dev-gabin/Retrace-Project/jetson_nano/client/wifi/README.md

# Wi-Fi client

Reserved for the future Wi-Fi relay client. The protocol and implementation
are intentionally not defined yet.
