dev-gabin/Retrace-Project/docs/pinmap.md

# Retrace 핀맵

> Retrace 프로젝트의 MCU 보드 3개(STM32 ×2, ESP32 ×1) 핀 배정과 설정 정리.
> 메시지 형식은 [protocol.md](protocol.md)를 참고합니다. Jetson Nano는 USB 장치만 연결하므로 핀맵 대상이 아닙니다.

| 보드 | 역할 | 프로젝트 폴더 | Jetson 연결 | 상태 |
|---|---|---|---|---|
| **STM32 #1** (NUCLEO-F411RE) | 메인 유닛 (Pan/Tilt 서보, 레이저, PIR) | `stm32/main_unit` | USB Serial (VCP) | 펌웨어·빌드 완료 / 실물 확인 전 |
| **STM32 #2** (NUCLEO-F411RE) | 서랍 노드 (서보 ×6, LED ×6, 비상 버튼) | `stm32/drawer` | Bluetooth (HC-06) | 펌웨어·빌드 완료 / 실물 확인 전 |
| **ESP32 #1** (LOLIN D32) | 현관등 (PIR, LED) | `esp32/entrance_node` | Wi-Fi · TCP | GPIO34/25 구현·빌드 완료 / 실물 확인 전 |

---

## 1. STM32 공통

두 STM32 보드 모두 같은 보드·같은 설정 기준을 사용합니다.

### 1-1. 보드 기본 설정 (두 보드 모두 유지)

> 표의 **헤더 핀**(D0~D15, A0~A5)은 NUCLEO 보드에 인쇄된 핀 이름입니다. 배선할 때 보드에서 바로 찾을 수 있습니다.  
> `CN7`, `CN10`은 보드 양옆의 긴 핀 줄입니다.

| 핀 | 용도 | 비고 |
|---|---|---|
| PA2, PA3 | USART2 → ST-LINK VCP | #1은 Jetson 통신, #2는 PC 명령·응답 테스트용. 헤더 D0/D1에는 기본적으로 연결되지 않음 |
| PA13, PA14, PB3 | SWD (TMS, TCK, SWO) | 업로드·디버깅용 |
| PA5 (D13) | LD2 녹색 LED | 디버깅용으로 사용 가능 |
| PC13 | B1 파란 버튼 (EXTI13) | 보드 기본 설정 유지 |
| PC14, PC15 / PH0, PH1 | 외부 크리스털 (LSE / HSE) | |

### 1-2. 클럭

| 항목 | 값 |
|---|---|
| 클럭 소스 | HSI 16MHz → PLL |
| SYSCLK / HCLK | 84 MHz |
| APB1 peripheral clock | 42 MHz |
| **APB1 timer clock** | **84 MHz** (메인 유닛 TIM3 기준 클럭) |

### 1-3. STM32 직접 구동 서보 PWM 계산

> 이 설정은 메인 유닛의 Pan/Tilt 서보에 적용합니다. 서랍 노드는 STM32 타이머 대신 I2C2로 연결한 PCA9685를 사용합니다.

| 항목 | 값 |
|---|---|
| Prescaler (PSC) | **83** |
| Counter Period (ARR) | **19999** |
| auto-reload preload | Enable |
| PWM Mode | PWM mode 1 |
| Output compare preload | Enable |
| CH Polarity | High |

```text
PWM 주파수 = 타이머 클럭 / ((PSC + 1) × (ARR + 1))

84 MHz ÷ (83 + 1) = 1 MHz    → 카운터 1 증가 = 1µs
1µs × (19999 + 1) = 20 ms    → 50Hz (서보 주기)
```

**Pulse 값 의미** (1 = 1µs)

| Pulse | 펄스 폭 | 서보 위치 (일반적) |
|---|---|---|
| 0 | PWM HIGH 신호 없음 | 위치 유지·움직임은 서보 실물에서 확인 |
| 1000 | 1.0 ms | 한쪽 끝 |
| 1500 | 1.5 ms | 중앙 |
| 2000 | 2.0 ms | 반대쪽 끝 |

- SG90은 제품마다 실제 동작 범위가 다를 수 있음 → 보드 테스트로 최소/최대값 확인 필요.

### 1-4. Project Manager

| 항목 | 값 |
|---|---|
| Toolchain / IDE | CMake |
| Firmware Package | STM32Cube FW_F4 **V1.28.3** (두 보드 동일, 최신 버전으로 마이그레이션하지 않음) |
| 주변장치 초기화 코드 위치 | `main.c` 안에 생성 (별도 `tim.c`, `usart.c` 파일 생성 안 함) |

> CubeMX에서 `.ioc`를 열 때 버전 마이그레이션 창이 뜨면 **Continue** 선택.  
> `Migrate to the latest supported Firmware version` 버튼은 누르지 않음 (팀원·강의실 환경 호환 유지).

### 1-5. 빌드 환경

| 항목 | 내용 |
|---|---|
| 에디터 | VS Code + **STM32CubeIDE for Visual Studio Code** 확장 팩 |
| 도구(번들) | 각 프로젝트 `.settings/bundles-lock.store.json`에 고정된 버전 사용 (CMake 4.3.1, Ninja 1.13.2, gnu-tools-for-stm32 14.3.1 — 두 프로젝트 동일) |
| 열 폴더 | `stm32/main_unit` 또는 `stm32/drawer` (각각 따로 열기) |
| 빌드 | `F7` (CMake: Build), 프리셋 `Debug` |
| 성공 기준 | 출력 탭 `CMake/빌드` → `빌드가 완료됨(종료 코드: 0)` |

- 빌드 결과물 `build/`는 각 프로젝트의 `.gitignore`로 제외됨.
- 줄바꿈 규칙은 최상위 `.gitattributes`(`* text=auto`)로 고정.

> **새 PC에서 빌드가 안 될 때** (`arm-none-eabi-gcc ... was not found in the PATH`)
> 1. 확장 **팩**(STM32CubeIDE for Visual Studio Code)이 설치됐는지 확인 — 일부 확장만 있으면 CMake가 컴파일러 위치를 모름
> 2. 프로젝트 폴더에서 VS Code 터미널로 `cube bundle install --project` (잠금 파일 기준으로 도구 설치)
> 3. `build/` 폴더 삭제 → `Developer: Reload Window` → STM32Cube 프로젝트 구성 **예** → `F7`

### 1-6. 공통 배선

| 항목 | 내용 |
|---|---|
| 서보 전원 | **외부 5V** 사용 (보드 5V에서 직접 X) |
| GND | 외부 5V 전원 GND와 NUCLEO GND **공통 연결** (필수) |

---

## 2. STM32 #1 메인 유닛 (레이저·Pan/Tilt·PIR)

### 2-1. 담당 기능

| 기능 | 설명 |
|---|---|
| Jetson 통신 | ST-LINK USB Serial(VCP), 명령 수신 / 이벤트 송신 (`protocol.md` 2장) |
| Pan/Tilt 서보 | SG90 ×2, 레이저 조준 |
| 레이저 | KY-008, ON/OFF |
| PIR | 공간 내 움직임 감지 → Jetson에 이벤트 전달 |

### 2-2. 핀 배정 (확정)

| 기능 | MCU 핀 | 헤더 핀 | 주변장치 | User Label |
|---|---|---|---|---|
| Jetson 통신 TX | PA2 | (D1, 기본 미연결) | USART2_TX | - |
| Jetson 통신 RX | PA3 | (D0, 기본 미연결) | USART2_RX | - |
| Pan 서보 | PA6 | D12 | TIM3_CH1 (PWM) | `SERVO_PAN` |
| Tilt 서보 | PA7 | D11 | TIM3_CH2 (PWM) | `SERVO_TILT` |
| 레이저 | PA8 | D7 | GPIO_Output | `LASER_EN` |
| PIR | PA10 | D2 | GPIO_EXTI10 | `PIR_IN` |

### 2-3. CubeMX 설정

**USART2 (Jetson 통신)**

| 항목 | 값 |
|---|---|
| Mode | Asynchronous |
| Baud Rate | **115200** |
| Word Length / Parity / Stop Bits | 8 / None / 1 |
| Data Direction | Receive and Transmit |
| NVIC | USART2 global interrupt **Enable** |

**TIM3 (Pan/Tilt)** — 1-3 공통 설정 + 아래

| 항목 | 값 |
|---|---|
| Channel1 / Channel2 | PWM Generation CH1 (PA6) / CH2 (PA7) |
| Pulse (CH1, CH2) | **1500** (중앙에서 시작) |

**PA8 (레이저)**

| 항목 | 값 |
|---|---|
| Mode | GPIO_Output |
| Output level | Low (부팅 시 레이저 OFF) |
| GPIO mode | Output Push Pull |
| Pull-up/Pull-down | No pull |
| Speed | Low |

**PA10 (PIR)**

| 항목 | 값 |
|---|---|
| Mode | GPIO_EXTI10 |
| GPIO mode | External Interrupt, Rising/Falling edge |
| Pull-up/Pull-down | Pull-down |
| NVIC | EXTI line[15:10] interrupts **Enable** |

- Rising = 움직임 감지 시작, Falling = 감지 종료 → 둘 다 받아서 활동 상태 판단에 사용.
- Pull-down: 센서가 빠졌을 때 입력이 떠서 오작동하는 것 방지.

> **주의: PA10(PIR)과 PC13(B1 버튼)은 같은 인터럽트(`EXTI15_10_IRQn`)를 공유함.**  
> 콜백(`HAL_GPIO_EXTI_Callback`)에서 `GPIO_Pin` 값으로 `PIR_IN_Pin`인지 `B1_Pin`인지 구분해서 처리해야 함.

### 2-4. 생성 코드에서 사용하는 이름

`Core/Inc/main.h`에 자동 생성됨.

| 매크로 | 값 |
|---|---|
| `SERVO_PAN_Pin` / `SERVO_PAN_GPIO_Port` | `GPIO_PIN_6` / `GPIOA` |
| `SERVO_TILT_Pin` / `SERVO_TILT_GPIO_Port` | `GPIO_PIN_7` / `GPIOA` |
| `LASER_EN_Pin` / `LASER_EN_GPIO_Port` | `GPIO_PIN_8` / `GPIOA` |
| `PIR_IN_Pin` / `PIR_IN_GPIO_Port` | `GPIO_PIN_10` / `GPIOA` |
| `PIR_IN_EXTI_IRQn` | `EXTI15_10_IRQn` |

### 2-5. 배선 메모

| 항목 | 내용 | 상태 |
|---|---|---|
| 레이저 | GPIO 직결 대신 트랜지스터 스위칭 검토 | 확인 필요 (모듈 전류) |
| PIR | 전원 5V, 출력 3.3V면 PA10 직결 가능 | 확인 필요 (모델) |

### 2-6. 진행 상황

- [x] CubeMX 핀 배정 (충돌 없음)
- [x] Clock 확인 → APB1 timer clock 84MHz, PSC 83 확정
- [x] 코드 생성 및 라벨·타이머 값 반영 확인
- [x] 명령 수신·AIM·LASER·HOME·PIR 이벤트 구현
- [x] 빌드 성공·경고 0개
- [ ] 레이저 모듈 모델 및 전류 확인
- [ ] PIR 센서 모델 및 출력 전압 확인
- [ ] 보드 업로드 및 동작 확인
- [ ] SG90 실제 동작 범위(Pulse 최소/최대) 측정

---

## 3. STM32 #2 서랍 노드

> 현재 핀 배정은 `drawer.ioc`와 아래 표를 기준으로 합니다. 통신 메시지는 `protocol.md` 기준입니다.

### 3-1. 담당 기능

| 기능 | 설명 |
|---|---|
| 서랍 팝업 서보 | SG90 ×6, PCA9685의 CH0~CH5로 제어 |
| 서랍 LED | LED ×6, 열린 서랍 표시 (타이머 자동 소등) |
| 비상 버튼 | Jetson 서버 로그 이벤트 (`EVT@clientID:SOS`); 폰 사이렌은 후속 구현 |
| Jetson 통신 | HC-06 Bluetooth (USART1) (`protocol.md` 3장) |
| PC 테스트 | ST-LINK VCP (USART2) — 명령 수신 · 응답 및 SOS 이벤트 |

### 3-2. 서랍 번호

`protocol.md`의 `clientID:OPEN:n`, `LED:n:ON`의 **n은 아래 번호**를 따릅니다. 서보·LED 번호도 같습니다.

```text
┌─────────┬─────────┐
│    1    │    2    │   Top
├─────────┼─────────┤
│    3    │    4    │   Middle
├─────────┼─────────┤
│    5    │    6    │   Bottom
└─────────┴─────────┘
   Left      Right
```

### 3-3. 핀 배정

**PCA9685 I2C 연결**

| PCA9685 핀 | STM32 핀 | 헤더 핀 | 설정 |
|---|---|---|---|
| SCL | PB10 | D6 | I2C2_SCL |
| SDA | PB9 | D14 | I2C2_SDA |
| VCC | 3.3V | | 로직 전원 |
| GND | GND | | 공통 접지 |

서보는 **1~6번 각 서랍 뒤에 1개씩** 설치하고, PCA9685 채널도 같은 번호 순서로 사용합니다.

| 서랍 | 위치 | PCA9685 채널 |
|---|---|---|
| 1 | 상단 왼쪽 | CH0 |
| 2 | 상단 오른쪽 | CH1 |
| 3 | 중단 왼쪽 | CH2 |
| 4 | 중단 오른쪽 | CH3 |
| 5 | 하단 왼쪽 | CH4 |
| 6 | 하단 오른쪽 | CH5 |

**서랍 LED**

| 서랍 | 핀 | 헤더 핀 | 설정 | User Label |
|---|---|---|---|---|
| 1 | PA0 | A0 | GPIO_Output | `LED_1` |
| 2 | PA1 | A1 | GPIO_Output | `LED_2` |
| 3 | PA4 | A2 | GPIO_Output | `LED_3` |
| 4 | PB0 | A3 | GPIO_Output | `LED_4` |
| 5 | PC1 | A4 | GPIO_Output | `LED_5` |
| 6 | PC0 | A5 | GPIO_Output | `LED_6` |

**HC-06 Bluetooth**

| HC-06 핀 | STM32 핀 | 헤더 핀 | 설정 |
|---|---|---|---|
| RXD | PA9 | D8 | USART1_TX (`HC06_TX`) |
| TXD | PA10 | D2 | USART1_RX (`HC06_RX`) |
| VCC | 5V | | 전원 |
| GND | GND | | 공통 접지 |

- TX ↔ RX **교차 연결** (STM32 TX → HC-06 RXD)
- STM32는 3.3V 로직이라 **전압 분배 저항 없이** 연결
- 서랍 보드엔 PIR이 없어서 PA10을 USART1_RX로 사용 (메인 유닛 STM32 #1과 다름)

**비상 버튼**

| 부품 핀 | STM32 핀 | 헤더 핀 | 설정 | User Label |
|---|---|---|---|---|
| 버튼 신호 | PB5 | D4 | GPIO_Input, Pull-up | `SOS_BTN` |
| 버튼 반대쪽 | GND | | 공통 접지 | |

- 평소 Pull-up으로 HIGH → 누르면 GND와 연결되어 LOW
- 인터럽트 없이 메인 루프에서 폴링하며 코드에서 50ms 디바운싱

**미사용 핀**

| 핀 | 상태 |
|---|---|
| PB1 | 사용 안 함 |

### 3-4. CubeMX 설정

**I2C2 (PCA9685)**

| 항목 | 값 |
|---|---|
| Mode | I2C |
| Clock Speed | **100000 Hz** (Standard Mode) |
| Addressing Mode | 7-bit |
| SCL / SDA | PB10 / PB9 |
| GPIO | Alternate Function Open Drain, No pull, Very High speed |
| DMA / NVIC | 사용 안 함 (폴링 방식) |
| PCA9685 주소 | 7-bit `0x40` (HAL 전달값 `0x40 << 1`) |
| PCA9685 PWM | **50Hz**, CH0~CH5 사용 |

> TIM3/TIM4는 사용하지 않습니다. 부팅 시 PCA9685 CH0~CH5를 Full OFF로 두고, 복귀·밀어내기 펄스 값은 실물 테스트에서 맞춥니다.

**USART1 (HC-06)**

| 항목 | 값 |
|---|---|
| Mode | Asynchronous |
| Baud Rate | **9600** (HC-06 기본값, 모듈 확인 필요) |
| Word Length / Parity / Stop Bits | 8 / None / 1 |
| NVIC | USART1 global interrupt **Enable** |

**USART2 (디버그)** — 보드 기본값 유지 (115200, VCP)

- USB 명령 테스트를 위해 USART2 NVIC는 `stm32f4xx_hal_msp.c`의 `USER CODE`에서 활성화하고, `stm32f4xx_it.c`의 `USER CODE`에 IRQ 핸들러를 정의합니다. `.ioc`는 변경하지 않았습니다.
- 나중에 CubeMX에서 USART2 global interrupt를 켜면 자동 생성 핸들러와 수동 핸들러가 중복되지 않도록 정리해야 합니다.

**GPIO**

| 핀 | 설정 |
|---|---|
| PA0, PA1, PA4, PB0, PC1, PC0 | GPIO_Output, Output level **Low**(부팅 시 꺼짐), Push Pull, No pull, Speed Low |
| PB5 | GPIO_Input, **Pull-up** (`SOS_BTN`) |
| NVIC | SOS 버튼 및 I2C2 인터럽트 사용 안 함 |

**Project Manager** — 1-4 공통 + Project Name `drawer`, Location `Retrace-Project/stm32/`

### 3-5. 배선 메모

| 항목 | 내용 |
|---|---|
| PCA9685 로직 전원 | VCC는 STM32 **3.3V**에 연결 |
| 서보 전원 | PCA9685 V+에 외부 **5~6V, 2A 이상** 권장 (서보 6개) |
| I2C | PB10(D6) → SCL, PB9(D14) → SDA; 모듈의 풀업 저항 사용 |
| GND | 외부 서보 전원 GND · PCA9685 GND · STM32 GND · HC-06 GND **공통 연결** |
| 서보 동작 | 코드에서 **한 번에 하나씩만** 움직이게 해서 전류 몰림 방지 |
| LED | 핀마다 **전류 제한 저항**(220~330Ω) 직렬 연결 |
| 비상 버튼 | 내부 Pull-up 사용 → 외부 저항 불필요, 채터링은 코드에서 처리 |

### 3-6. 진행 상황

- [x] 프로젝트 생성 (`drawer.ioc`, NUCLEO-F411RE, 보드 기본 설정)
- [x] TIM3/TIM4 비활성화
- [x] I2C2: PB10/PB9 = SCL/SDA, Standard Mode 100kHz
- [x] PCA9685: CH0~CH5 = 서랍 1~6, 50Hz 제어 코드 구현
- [x] USART1: PA9/PA10 = `HC06_TX`/`HC06_RX`, 9600, NVIC
- [x] GPIO: PA0/PA1/PA4/PB0/PC1/PC0 = `LED_1~6`
- [x] PB5 = `SOS_BTN` (GPIO Input, Pull-up, 폴링)
- [x] Project Manager → 코드 생성
- [x] UART 명령 · LED · 서보 순차 밀기·복귀 · 10초 소등 · SOS 이벤트 구현
- [x] PCA9685 전환 후 Debug 빌드 성공·경고 0개
- [ ] I2C 연결 · PCA9685 주소 · 서보 펄스 보정 · 보드 업로드 및 실물 동작 확인

### 3-7. 확인 필요 항목

- [ ] 서랍 실제 배치 (2열× 3행 맞는지, LED 연결이 위 번호 그림과 일치하는지)
- [ ] HC-06 통신 속도 (9600 기본값인지)
- [ ] PCA9685 주소 `0x40` 응답 및 50Hz 출력 확인
- [ ] 서보 복귀 / 밀어내기 Pulse 값 보정 (현재 1000µs / 2000µs)
- [ ] PB1 미사용 이유 기록

---

## 4. ESP32 공통

### 4-1. 개발 방식

| 항목 | 내용 |
|---|---|
| 개발 도구 | VS Code + **PlatformIO** (STM32와 같은 에디터) |
| 프레임워크 | Arduino 프레임워크 (`setup()` / `loop()`) |
| 설정 파일 | 각 프로젝트의 `platformio.ini` (보드 · 라이브러리 버전) |
| 핀 설정 | CubeMX 같은 설정 화면 없음 → **코드에서 직접** (`pinMode()`) |
| 빌드 결과물 | `.pio/` → `.gitignore`로 제외 |

### 4-2. 피해야 할 핀 (확인 필요 — 보드 문서로 최종 확인)

ESP32는 **전원 켤 때 부팅 방식을 정하는 핀(스트래핑 핀)**이 있어서, 여기에 부품을 달면 부팅이 안 될 수 있습니다.

| 보드 | 피할 핀 | 이유 |
|---|---|---|
| LOLIN D32 | GPIO0, 2, 5, 12, 15 | 부팅 모드 결정 (스트래핑) |
| LOLIN D32 | GPIO6~11 | 내부 플래시 메모리 연결 |
| LOLIN D32 | GPIO34~39 | **입력 전용** (출력 불가, 내부 풀업·풀다운 없음) |
| ESP32-C3 | GPIO2, 8, 9 | 부팅 모드 결정 (스트래핑) |
| ESP32-C3 | GPIO18, 19 | USB 연결 (업로드·시리얼) |
| ESP32-C3 | GPIO20, 21 | UART0 (기본 시리얼) |

---

## 5. ESP32 #1 현관등 (LOLIN D32)

### 5-1. 담당 기능

| 기능 | 설명 |
|---|---|
| 외출 감지 | PIR 움직임 → TCP `EVT@ENTRANCE:PIRON` |
| 현관등 | 평소 센서등 점등 / Jetson `ALERT` 명령 시 경고 점등 |
| Jetson 통신 | Wi-Fi · 인증 TCP client (`protocol.md` 4장) |

### 5-2. 코드에 반영한 핀 배정 (실물 검증 전)

| 부품 | 핀 | 설정 | 코드 상수 |
|---|---|---|---|
| PIR 출력 | **GPIO34** | `INPUT` | `PIR_PIN` |
| 현관등 LED | **GPIO25** | `OUTPUT`, 초기 LOW, 한 색 LED | `LIGHT_PIN` |

- **PIR → GPIO34**: 입력 전용 핀이라 센서 입력에 적합. 내부 풀다운이 없으므로 센서가 빠졌을 때 오작동이 걱정되면 **외부 10kΩ 풀다운** 추가
- **현관등 LED**: GPIO25로 제어. 저항 내장 모듈이 아니면 220~330Ω 전류 제한 저항을 직렬 연결.

- PIR 50ms 필터, 움직임 종료 후 7초 점등 유지. `ALERT`는 250ms마다 ON/OFF하며 10초 후 기본 센서등 모드로 복귀.
- Wi-Fi·TCP가 없어도 기본 센서등 동작. 실제 업로드·PIR·LED·네트워크 검증은 강의실에서 진행.

### 5-3. 배선 메모

| 항목 | 내용 | 상태 |
|---|---|---|
| 전원 | USB 5V 어댑터 (시연용) | |
| PIR 전원 | HC-SR501은 5V 필요, 출력은 3.3V라 GPIO 직결 가능 | 확인 필요 (모델) |
| 배터리 | 배터리로만 쓰면 5V가 없을 수 있음 → 3.3V용 PIR(AM312 등) 검토 | 시연은 USB 전원 |

---

### 5-4. 진행 상황

- [x] PIR 센서등·시간 유지·NORMAL/ALERT·Wi-Fi/TCP·재연결 구현
- [x] 기본·네트워크 활성화 빌드 성공·경고 0개
- [ ] 개인 `network_config.h`에 Wi-Fi·Jetson IP 입력 후 실제 보드용 `lolin_d32` 재빌드·업로드
- [ ] PIR·LED 구동, 실제 TCP 로그인·이벤트·연결 유실 검증

---

## 6. 전체 확인 필요 항목

- [ ] STM32 #1: 레이저 모듈 전류, PIR 모델, SG90 동작 범위
- [ ] STM32 #2: PCA9685 I2C 연결·주소, 서랍 실제 배치, HC-06 통신 속도, 서보 밀기·복귀 펄스와 시간 보정, PB1 미사용 이유
- [ ] ESP32 #1: PIR 모델, 한 색 LED 구동 회로·실제 점등, Wi-Fi/TCP 연결

실행 항목과 결과 기록은 [강의실 통합 테스트](classroom_test_checklist.md)에서 관리합니다. 보드 단독 검증 후 feature → develop PR로 기능을 통합하고 Jetson·웹과 전체 연동을 확인합니다.
