dev-gabin/Retrace-Project/docs/protocol.md

# Retrace 통신 프로토콜

> 각 보드가 주고받는 메시지 약속입니다. **보내는 쪽과 받는 쪽 모두 이 문서를 기준으로 구현합니다.**  
> 문서와 다르게 동작하면 **문서와 다른 쪽이 수정**합니다. 변경이 필요하면 문서를 먼저 고치고 서로 공유합니다.
>
> 버전: **v0.8** — 현재 `develop` 구현 기준입니다.
> 보드 핀 배정은 [pinmap.md](pinmap.md), 실행·검증 항목은 [통합 테스트 체크리스트](classroom_test_checklist.md)를 참고합니다.

---

## 0. 전체 연결

| 연결 | 방식 | 보드 쪽 (담당: 본인) | Jetson 쪽 (담당: 짝꿍) |
|---|---|---|---|
| Jetson ↔ STM32 #1 메인 유닛 | USB Serial (VCP) | `stm32/main_unit` | `Stm32Link` |
| Jetson ↔ STM32 #2 서랍 | Bluetooth (HC-06) | `stm32/drawer` | `DrawerLink` |
| Jetson ↔ ESP32 #1 현관등 (LOLIN D32) | Wi-Fi · TCP | `esp32/entrance_node` | 인증 client |
| Jetson → 스마트폰 | ntfy (HTTP) | - | `PhoneNotifier` |
| Web/PWA ↔ Jetson | HTTP | - | `Server` |

> 카메라는 Jetson에 USB로 직접 연결되며(영상 입력), 이 문서의 메시지 대상이 아닙니다.

---

## 1. 시리얼 공통 규칙 (STM32 #1, STM32 #2)

USB Serial과 Bluetooth(HC-06) 모두 **같은 문자 형식**을 씁니다. PC 시리얼 터미널로 직접 입력해서 테스트할 수 있습니다.

| 항목 | 규칙 |
|---|---|
| 문자 | ASCII |
| 대소문자 | **대문자만** 사용. 보내는 쪽·받는 쪽 모두 대문자 기준이며, 소문자가 섞인 명령은 `ERR:UNKNOWN` (테스트할 때도 대문자로 입력) |
| 형식 | 필드는 `:`로 구분, 한 필드 안의 여러 값은 `,`로 구분 (예: `AIM:120,45`, `DRAWER:OPEN:3`, `LED:3:ON`) |
| 줄 끝 | `\n` (LF) 한 개로 메시지 하나 끝 (`\r`은 받는 쪽에서 무시) |
| 공백 | 사용하지 않음 |
| 최대 길이 | 32바이트 (`\n` 포함) |

### 응답 · 이벤트

| 종류 | 형식 | 예 |
|---|---|---|
| 성공 응답 | `OK:명령` | `OK:AIM` |
| 실패 응답 | `ERR:명령:이유` | `ERR:AIM:RANGE` |
| 모르는 명령 | `ERR:UNKNOWN` | |
| 보드가 먼저 보내는 이벤트 | `EVT@종류:값` | `EVT@PIR:1` |

- 명령을 받으면 **반드시 `OK` 또는 `ERR`로 응답**합니다.
- Jetson은 응답을 **1초** 기다리고, 없으면 **1회 재전송**합니다. 그래도 없으면 연결 오류로 처리합니다.
- **이벤트(`EVT:`)는 언제든 올 수 있습니다.** Jetson은 응답을 기다리는 중에도 `EVT:`로 시작하는 줄은 응답이 아니라 **이벤트로 처리**하고, 계속 응답을 기다립니다.

```text
Jetson → AIM:90,90
STM32  → EVT@PIR:1     ← 응답 대기 중 이벤트 도착 → 이벤트로 처리
STM32  → OK:AIM        ← 이게 AIM의 응답
```

### 공통 명령

| 명령 | 응답 | 설명 |
|---|---|---|
| `PING` | `OK@PING` | 연결 확인 |

---

## 2. Jetson ↔ STM32 #1 메인 유닛 (USB Serial)

카메라와 STM32 #1은 **같은 메인 유닛**에 배치하며, STM32 #1과 Jetson은 USB로 연결합니다.

| 항목 | 값 |
|---|---|
| 포트 | ST-LINK VCP (STM32 USART2: PA2/PA3), Jetson에서 `/dev/ttyACM*` |
| 설정 | 115200, 8N1 |

### Jetson → STM32 #1

| 명령 | 응답 | 설명 |
|---|---|---|
| `AIM:pan,tilt` | `OK:AIM` | 서보 각도 이동. 각도는 **0~180 정수(도)** |
| `LASER:ON` | `OK:LASER` | 레이저 켜기 |
| `LASER:OFF` | `OK:LASER` | 레이저 끄기 |
| `HOME` | `OK:HOME` | 서보 중앙(90,90) + 레이저 OFF |

- 범위 밖 각도 → `ERR:AIM:RANGE`
- 카메라 좌표 → 각도 변환(조준 보정)은 **Jetson**에서 하고, STM32는 **받은 각도만** 서보 펄스로 바꿉니다.
- 각도 → 펄스 변환(SG90 최소/최대 펄스)은 STM32가 담당합니다.

### STM32 #1 → Jetson (이벤트)

| 이벤트 | 설명 |
|---|---|
| `EVT@PIR:1` | 움직임 감지 시작 |
| `EVT@PIR:0` | 움직임 감지 종료 |

예시:

```text
Jetson → AIM:120,45
STM32  → OK:AIM
Jetson → LASER:ON
STM32  → OK:LASER
STM32  → EVT@PIR:1
```

---

## 3. Jetson ↔ STM32 #2 서랍 (Bluetooth, HC-06)

| 항목 | 값 |
|---|---|
| 연결 | HC-06 (Bluetooth Classic, SPP) ↔ STM32 USART1 (PA9/PA10), Jetson에서 `/dev/rfcomm*` |
| 설정 | **9600**, 8N1 (HC-06 기본값, 모듈 확인 필요) |
| Jetson 쪽 | USB Bluetooth 동글 (CSR 4.0) |

> STM32 #2의 USART2(VCP, 115200 8N1)는 **PC 단독 테스트용**으로 같은 명령을 받습니다. 응답은 명령을 받은 UART로 보내며, SOS 이벤트는 USART1과 USART2 양쪽으로 보냅니다. Jetson 연결은 USART1(HC-06)을 사용합니다.

**서랍 번호 n** (서보·LED 번호와 동일, `pinmap.md` 3-2)

```text
┌─────────┬─────────┐
│    1    │    2    │   Top
├─────────┼─────────┤
│    3    │    4    │   Middle
├─────────┼─────────┤
│    5    │    6    │   Bottom
└─────────┴─────────┘
   Left      Right
```

### Jetson → STM32 #2

| 명령 | 응답 | 설명 |
|---|---|---|
| `DRAWER:OPEN:n` | `OK:DRAWER` | n번 서랍(1~6) LED ON + 팝업 서보 동작 |
| `LED:n:ON` | `OK:LED` | n번 LED만 켜기 |
| `LED:n:OFF` | `OK:LED` | n번 LED만 끄기 |
| `LED:ALL:OFF` | `OK:LED` | 전체 LED 끄기 |

- 범위 밖 번호 → `ERR:DRAWER:RANGE`, `ERR:LED:RANGE`
- 서보 밀어내기·복귀는 **STM32가 처리**합니다. Jetson은 서랍 번호만 보냅니다. 현재 밀기 2000µs / 복귀 1000µs, 각각 500ms이며 실물 보정 전 임시값입니다. 복귀는 서보 팔 복귀이며 서랍을 자동으로 닫지 않습니다.
- LED 점등 명령 이후 마지막 점등 시각부터 현재 **10초** 뒤 STM32가 자동 소등합니다. 서랍 닫힘 감지는 없습니다. 시간은 강의실에서 조정합니다.
- 새 `DRAWER:OPEN`이 오면 **이전 LED는 즉시 소등**하고 새 서랍만 켭니다.
- 서보는 한 번에 하나만 구동합니다. 동작 중 새 요청을 받으면 기존 서보를 복귀시키고 새 서랍을 구동합니다. 복귀 중 여러 요청이 오면 마지막 요청을 예약합니다 (`OK:DRAWER`는 요청 접수 응답).

### STM32 #2 → Jetson (이벤트)

| 이벤트 | 설명 |
|---|---|
| `EVT:BTN:SOS` | 비상 버튼 눌림 (폰 사이렌 요청) |

- 버튼 떨림(채터링) 처리는 **STM32**에서 하고, 한 번 누르면 이벤트 **한 번만** 보냅니다.

예시:

```text
Jetson → DRAWER:OPEN:3
STM32  → OK:DRAWER
STM32  → EVT:BTN:SOS
```

---

## 4. Jetson ↔ ESP32 #1 현관등 (Wi-Fi · TCP)

| 항목 | 값 |
|---|---|
| 보드 | LOLIN D32 (PIR + 현관등 LED) |
| 서버 | Jetson `server_jetson`, 기본 포트 5000 |
| 클라이언트 ID | `ENTRANCE` (설정 파일에서 변경 가능) |

연결 직후 `[ID:비밀번호]`로 로그인합니다. 이후 모든 송신은 줄바꿈으로 끝납니다.

| 방향 | 메시지 | 내용 |
|---|---|---|
| 현관등 → Jetson | `[SERVER]EVT@ENTRANCE:PIRON` | 안정적인 PIR LOW → HIGH 감지 |
| Jetson → 현관등 | `[발신자]PING` | 연결 확인 요청 |
| 현관등 → Jetson | `[SERVER]OK@PING` | 연결 확인 응답 |
| Jetson → 현관등 | `[발신자]NORMAL` / `[발신자]ALERT` | 기본 점등 / 경고 점멸 |
| 현관등 → Jetson | `[SERVER]OK@LIGHT:NORMAL` / `[SERVER]OK@LIGHT:ALERT` | 조명 명령 접수 |

- 평소 센서등 점등은 현관등이 자체 처리하고, `ALERT`만 Jetson이 보냅니다.
- `ALERT`는 10초 후 자동으로 기본 센서등 상태로 복귀합니다.

구현 기준 (`esp32/entrance_node`):

- PIR은 50ms 필터 후 LOW → HIGH 전환마다 `EVT@CLIENT_ID:PIRON`을 한 번 전송합니다. HIGH 유지 중에는 중복 전송하지 않습니다.
- 한 색 LED(GPIO25)는 PIR이 HIGH인 동안 켜지고, 안정적인 LOW 감지 후 **7초** 유지합니다.
- `ALERT`는 **250ms마다 ON/OFF**하며 **10초** 후 기본 센서등 모드로 복귀합니다. 새 `ALERT`는 시간을 갱신하고 ON부터 다시 시작합니다. `NORMAL`은 경고를 취소하며, PIR 점등 조건이 남아 있으면 LED는 켜져 있습니다.
- 시간은 `src/main.cpp` 맨 위의 임시 상수로, 강의실에서 조정합니다.
- 명령은 대문자 `NORMAL` / `ALERT`와 정확히 일치해야 합니다.
- Wi-Fi·TCP 연결은 별도 태스크에서 처리합니다. 연결이 없어도 기본 PIR 센서등과 경고 복귀 타이머는 계속 동작합니다. 서버 연결은 5초 간격으로 재시도하며, 5초 이상 지난 PIR 이벤트는 버립니다.
- Wi-Fi·Jetson 주소는 Git에서 제외되는 `include/network_config.h`에 설정합니다. 예제 설정이 비어 있으면 기본 PIR 센서등만 동작합니다.

연결 확인 (Jetson TCP client에서):

```text
[SERVER]PING@ENTRANCE
```

---

## 5. Jetson → 스마트폰 (ntfy)

| 항목 | 값 |
|---|---|
| 서버 | Jetson (ntfy) |
| 토픽 | `retrace-phone` |

| 알림 | 우선순위 | 제목 (헤더) | 본문 | 설명 |
|---|---|---|---|---|
| 폰 사이렌 (비상 버튼) | **5 (max)** | `Retrace SOS` | `폰을 찾고 있어요!` | 앱 설정 "최고 우선순위 계속 울리기"로 반복 알림 |
| 외출 알림 | **3 (default)** | `Car Key Check` | `차키 챙기셨나요?` | 한 번만 알림 |

- 제목은 HTTP **헤더**로 보내서 한글이 깨질 수 있으므로 **영문**, 한글 문구는 **본문**에 넣습니다.

테스트:

```bash
curl -H "Priority: 5" -H "Title: Retrace SOS" -d "폰을 찾고 있어요!" http://localhost/retrace-phone
```

---

## 6. Web/PWA ↔ Jetson (HTTP API)

| 메서드 | 경로 | 설명 |
|---|---|---|
| GET | `/api/items` | 전체 물건 Last Seen 목록 |
| GET | `/api/items/{item}` | 특정 물건 Last Seen |
| POST | `/api/items/{item}/aim` | 저장된 카메라 좌표로 레이저 안내 요청. 서랍 보관·좌표 없음은 HTTP 409, 레이저 연결·보정 없음은 HTTP 503 |
| POST | `/api/drawers/{n}/open` | n번 서랍 열기 |
| GET | `/snapshots/{file}` | 스냅샷 이미지 |

### 6-1. 웹 뼈대에서 사용하는 JSON 임시안

`web` 화면과 Jetson의 `vision/http_api.py`는 아래 메서드·경로를 사용합니다.

저장 데이터의 시각·사진 경로·좌표·서랍 번호 표현은 7장의 Storage API 기준에 맞춥니다. `Retrace_API_Guide_v2.pdf`는 Jetson 내부 C API를 정의하므로, HTTP 경로·JSON 구조·HTTP 오류 코드와 저장 모듈 반환 코드의 변환은 웹·Jetson 담당자가 별도로 확정합니다.

| 요청 | 요청 본문 | 성공 응답 (HTTP 200) |
|---|---|---|
| `GET /api/items` | 없음 | `{ "items": [LastSeen, ...] }` |
| `GET /api/items/{item}` | 없음 | `LastSeen` 객체 |
| `POST /api/items/{item}/aim` | `{}` | `{ "ok": true }` 또는 `NO_POSITION` / `LASER_UNAVAILABLE` 오류 |
| `POST /api/drawers/{n}/open` | `{}` | `{ "ok": true }` |

POST는 `Content-Type: application/json`을 사용합니다. 웹은 UART·장치 TCP 연결을 직접 제어하지 않습니다. 레이저 안내는 웹 버튼 요청 시 저장된 카메라 좌표를 사용하며 최대 5초 점등 후 소등·중앙 복귀합니다. 마지막 확인 사진과 시각도 유지합니다. PIR·현관등·폰 알림 경로에서 레이저를 자동으로 켜지 않습니다.

`LastSeen` 예제 (7장 필드 이름 사용):

```json
{
  "item": "car_key",
  "pos_x": 412,
  "pos_y": 288,
  "seen_at": "2026-10-03T05:22:05.000000Z",
  "snapshot": "snapshots/rt_0123456789abcdef0123456789abcdef.jpg",
  "drawer_id": null,
  "state": "visible"
}
```

- `item`: `carkey` / `airpods` / `wallet`. 화면 이름은 웹에서 차키 / 에어팟 / 지갑으로 표시합니다.
- `pos_x`, `pos_y`: 저장하는 전체 프레임 JPEG의 픽셀 좌표이며, 둘 다 0 이상의 정수 또는 둘 다 `null`입니다. 좌표는 해당 이미지 범위 안에 있어야 합니다. C 구조체의 `has_position`으로 좌표 존재 여부를 구분합니다.
- `seen_at`: UTC `YYYY-MM-DDTHH:MM:SS.ffffffZ` 문자열 또는 `null`. 등록됐지만 관측 전인 물건은 C 조회 결과가 `RT_OK`, `observed == 0`입니다. 이 경우 JSON 임시안에서는 시간·좌표·사진·서랍 필드를 `null`로 보내고 웹은 기록 없음으로 표시합니다. 미등록 물건과 구분합니다.
- `snapshot`: `data_dir` 기준 `snapshots/rt_<소문자 16진수 32자리>.jpg` 상대 경로 또는 `null`. 웹은 동일 서버의 `GET /snapshots/{file}`로 표시합니다. 임의 외부 주소나 상위 폴더 경로는 받지 않습니다.
- `drawer_id`: JSON에서는 1~6 정수 또는 `null`. C API의 `0`은 서랍 없음이며 DB에서는 SQL `NULL`로 저장되므로, 서버가 JSON `null`로 변환합니다. `state`: `visible` / `occluded` / `uncertain`.
- `observed`와 `has_position`은 C 조회 구조체의 판별 필드입니다. HTTP 응답에 이 필드를 직접 포함할지와 JSON 타입은 웹·Jetson 담당자가 확정합니다.
- `{ "ok": true }`는 **서버의 요청 접수 응답**이며, 실제 서보 이동·레이저 점등 완료를 뜻하지 않습니다. 보드 응답 대기·장치 오류 처리 방식은 Jetson 담당자가 추가로 확정합니다.
- 실패는 HTTP 4xx/5xx와 `{ "error": { "code": "ITEM_NOT_FOUND", "message": "물건 기록이 없습니다." } }` 형태의 임시안을 사용합니다. 웹은 실패·시간 초과를 표시하며, 실제 연결 실패 시 샘플 성공으로 바꾸지 않습니다.
웹 기본 설정은 샘플 모드이며 실제 API 요청을 보내지 않습니다. 실행·연동 전환·검증 방법은 [`web/README.md`](../web/README.md)를 참고합니다.

---

## 7. Jetson 저장 데이터·C Storage API (Last Seen)

기준: 짝꿍이 작성한 `Retrace_API_Guide_v2.pdf` (Retrace Storage API 안내).
`storage.h`에 공개된 Jetson 내부 C 저장 API를 사용하며, Python이 저장한 JPEG의 상대 경로를 검증하고 관측 정보와 함께 **MariaDB**에 기록합니다. 아래 필드는 C 조회 구조체 `RtRecord` 기준입니다. 실제 SQL 스키마와 HTTP 직렬화 구현은 Jetson 저장·서버 모듈에서 관리합니다.

### 7-1. 최신 관측 정보 (`RtRecord`)

| C 필드 | 의미·규칙 | DB·HTTP 표현 |
|---|---|---|
| `item[33]` | 등록된 물건 ID, 최대 32자 | 예: `carkey` |
| `observed` | 관측 기록 존재 여부 (0/1) | 관측 전 등록 물건도 조회 결과에 포함되며 `observed == 0` |
| `has_position` | 좌표 존재 여부 | 좌표는 둘 다 존재하거나 둘 다 DB `NULL`; HTTP 임시안은 정수 쌍 또는 `null` 쌍 |
| `pos_x`, `pos_y` | 전체 카메라 화면 기준 픽셀 좌표 | 저장 JPEG의 전체 프레임 기준, 화면 밖 좌표는 저장 거부 |
| `seen_at[28]` | UTC `YYYY-MM-DDTHH:MM:SS.ffffffZ` | 예: `2026-10-03T05:22:05.000000Z` |
| `snapshot[256]` | `data_dir` 기준 사진 상대 경로 | `snapshots/rt_<소문자 16진수 32자리>.jpg` |
| `drawer_id` | C API에서 `0`은 서랍 없음, `1~6`은 서랍 번호 | `0`은 SQL `NULL`; HTTP 임시안에서는 JSON `null` |
| `state` | `visible` / `occluded` / `uncertain` 중 하나 | 같은 문자열 사용 |

- **미등록 물건**: `rt_get()`은 `RT_NOT_FOUND`를 반환합니다.
- **등록됐지만 관측 전인 물건**: `rt_get()`은 `RT_OK`이며 `row->observed == 0`입니다. `rt_list()`에도 포함됩니다.
- `observed`와 `has_position`은 조회 상태를 구분하는 C 필드입니다. 물리적 DB 열이나 최종 HTTP 응답 필드로 확정한 것은 아닙니다.

### 7-2. 연결 설정과 핸들

| `RtConfig` 필드 | 의미 |
|---|---|
| `host` | MariaDB 주소. 예: `127.0.0.1` |
| `user` / `password` | MariaDB 애플리케이션 계정·비밀번호 |
| `database` | DB 이름. 예: `retrace` |
| `data_dir` | 사진과 잠금 파일을 둘 데이터 디렉터리 |
| `port` | MariaDB 포트. 보통 `3306` |

사용 순서: `RtConfig` 준비 → `rt_open()` → 조회·저장 → `rt_close()`.
`RtStore`는 내부 연결을 감추는 핸들이며, **핸들 하나는 한 스레드에서 사용**합니다.
`rt_open()` 성공 시 `*out`에 핸들을 돌려주고, 실패 시 `*out`은 `NULL`이며 호출자가 제공한 `error` 버퍼에 원인이 기록됩니다.

### 7-3. 공개 C API

| 함수 | 역할·호출자 처리 |
|---|---|
| `rt_open(RtStore **out, const RtConfig *config, char *error, size_t error_size)` | MariaDB 연결과 데이터·사진 디렉터리 준비. 성공 `RT_OK`, 실패 `RT_ERROR` |
| `rt_close(RtStore *store)` | DB·파일 핸들 해제. 반환형 `void` |
| `rt_error(const RtStore *store)` | 마지막 오류 문구 반환 (`const char *`). `NULL` 핸들은 `No storage handle` |
| `rt_list(RtStore *store, RtRecord **rows, size_t *count)` | 등록 물건 전체의 최신 정보 조회. 성공 후 호출자가 `free(rows)` |
| `rt_get(RtStore *store, const char *item, RtRecord *row)` | 물건 ID 하나의 최신 정보 조회 |
| `rt_save(RtStore *store, const char *item, int x, int y, const char *utc_time, int drawer_id, const char *state, const char *snapshot_path)` | 미리 저장된 전체 프레임 JPEG 검증 및 관측 정보 저장 |
| `rt_load_snapshot(RtStore *store, const char *item, unsigned char **jpeg, size_t *jpeg_size)` | 현재 사진 바이트 조회. 성공 후 호출자가 `free(*jpeg)`. 관측 또는 사진이 없으면 `RT_NOT_FOUND` |
| `rt_recover(RtStore *store, size_t *removed)` | DB가 참조하지 않는 관리 사진·임시 파일 정리. 삭제한 파일 수를 `removed`로 반환 |

`rt_close()`와 `rt_error()` 외 함수의 반환형은 `int`입니다. 반환값은 다음 절의 저장 모듈 코드이며, UART 응답이나 HTTP 상태 코드와 구분합니다.

### 7-4. 반환 코드

| 코드 | 값 | 의미·처리 |
|---|---|---|
| `RT_OK` | `0` | 성공 |
| `RT_NOT_FOUND` | `1` | 물건 또는 사진 없음. `rt_save()`에서는 미등록 물건 |
| `RT_STALE` | `2` | 저장 시각이 기존 기록과 같거나 과거라 변경하지 않음 |
| `RT_ERROR` | `-1` | 일반 오류. 열린 핸들에서는 `rt_error()`로 원인 확인 |
| `RT_COMMIT_UNKNOWN` | `-2` | DB 커밋 결과 불확실. 입력 사진을 보존하고 재접속·조회·복구로 결과 확인 |
| `RT_CLEANUP_PENDING` | `3` | DB 저장은 성공했으나 이전 파일 정리 또는 동기화가 남음 |

`RT_COMMIT_UNKNOWN`을 저장 실패 확정으로 처리해 입력 사진을 삭제하지 않습니다. `RT_CLEANUP_PENDING`은 DB 저장 성공과 후속 정리 상태를 구분해서 처리합니다.

### 7-5. 사진 저장·복구 규칙

1. Python이 전체 프레임 JPEG를 `RETRACE_DATA_DIR/snapshots`에 **완전히 기록하고 파일을 닫습니다**. 이 경로는 C의 `data_dir` 아래 사진 디렉터리와 일치시킵니다.
2. 매 저장마다 고유한 이름을 사용하고, 다음 형식의 **상대 경로**를 `rt_save()`에 전달합니다.

   ```text
   snapshots/rt_<소문자 16진수 32자리>.jpg
   예: snapshots/rt_0123456789abcdef0123456789abcdef.jpg
   ```

3. C 저장 모듈이 경로·일반 파일 여부·JPEG 유효성·전체 프레임 좌표 범위를 검증합니다.
4. DB 잠금과 트랜잭션으로 최신 정보를 갱신하며, 기존 기록보다 **새로운 UTC 시각**의 요청만 반영합니다. 커밋 뒤 이전 관리 사진을 정리합니다.
5. 호출 후 입력 사진을 변경하거나 덮어쓰지 않습니다. DB가 참조 중인 파일을 임의로 삭제하지 않습니다.

저장 실패로 DB가 참조하지 않는 새 파일도 즉시 삭제되지는 않습니다. `rt_recover()`가 관리 파일명 규칙에 맞는 고아 사진과 임시 파일을 나중에 정리합니다.
**Python 저장 작업이 멈춰 있을 때만 복구를 실행**합니다. 저장과 동시에 실행하면 DB에 등록되기 전의 새 파일을 지울 수 있습니다. DB 오류나 참조 중인 사진 누락이 있으면 복구 중 삭제를 멈춥니다.

### 물건 이름 (item)

| 이름 | 물건 |
|---|---|
| `car_key` | 차키 (YOLO class 80) |
| `wallet` | 지갑 (YOLO class 81) |
| `earphones` | 이어폰 및 충전 케이스 (YOLO class 82) |

> 학습 데이터셋 클래스 이름도 위 이름과 **똑같이** 맞춥니다.

---

## 확정 필요 항목

- [ ] HC-06 실제 통신 속도 (기본 9600인지 모듈 확인)
- [ ] 서랍 LED 10초 소등 / 현관등 기본 점등 7초·ALERT 10초·깜빡임 250ms를 실물에 맞춰 최종 확인
- [ ] ntfy 서버 포트
- [x] HTTP API 경로·JSON과 장치 오류 응답 구현
- [x] Storage 응답을 HTTP JSON·상태 코드로 변환
- [ ] 추적 물건 목록 최종 확정 (안경 / 지갑)

---

## 변경 기록

| 버전 | 내용 |
|---|---|
| v0.1 | 최초 초안 |
| v0.2 | 대소문자 규칙(**대문자만**, 소문자는 `ERR:UNKNOWN`), 보드 이름·담당·폴더 표기 통일, 서랍 번호 그림, STM32 #2 USART1·디버그 USART2 구분, 핀맵 문서 연결 |
| v0.3 | 이벤트 끼어들기 처리 규칙, 당시 `PING` 응답 형식 통일, 형식 설명(`:` / `,`) 수정, ntfy 제목 영문·본문 한글로 통일, MQTT 대소문자 범위(연결 상태는 관례대로 소문자) 명시 |
| v0.4 | 서랍 번호 배치를 pinmap.md 3-2 기준(2열 × 3행)으로 통일 |
| v0.5 | 현관등 PIR·ALERT·QoS 1 구현 기준 명시 |
| v0.6 | `Retrace_API_Guide_v2.pdf` 기준으로 MariaDB·C Storage API, 관측 여부·좌표 여부, UTC 시각·사진 경로, 반환 코드·복구 규칙 반영. 관련 Last Seen JSON 예제 수정, HTTP 형식은 초안 유지 |
| v0.7 | 사용하지 않는 ESP32-C3 태그 관련 연결·API 초안 제거, 이후 장 번호 정리 |
| v0.8 | 현관등 통신을 MQTT에서 인증 TCP client로 변경하고 구현된 HTTP API 기준으로 갱신 |
