dev-gabin/Retrace-Project/stm32/drawer/Core/Inc/main.h

#define B1_Pin GPIO_PIN_13
#define B1_GPIO_Port GPIOC
#define LED_6_Pin GPIO_PIN_0
#define LED_6_GPIO_Port GPIOC
#define LED_5_Pin GPIO_PIN_1
#define LED_5_GPIO_Port GPIOC
#define LED_1_Pin GPIO_PIN_0
#define LED_1_GPIO_Port GPIOA
#define LED_2_Pin GPIO_PIN_1
#define LED_2_GPIO_Port GPIOA
#define USART_TX_Pin GPIO_PIN_2
#define USART_TX_GPIO_Port GPIOA
#define USART_RX_Pin GPIO_PIN_3
#define USART_RX_GPIO_Port GPIOA
#define LED_3_Pin GPIO_PIN_4
#define LED_3_GPIO_Port GPIOA
#define LD2_Pin GPIO_PIN_5
#define LD2_GPIO_Port GPIOA
#define LED_4_Pin GPIO_PIN_0
#define LED_4_GPIO_Port GPIOB
#define HC06_TX_Pin GPIO_PIN_9
#define HC06_TX_GPIO_Port GPIOA
#define HC06_RX_Pin GPIO_PIN_10
#define HC06_RX_GPIO_Port GPIOA
#define TMS_Pin GPIO_PIN_13
#define TMS_GPIO_Port GPIOA
#define TCK_Pin GPIO_PIN_14
#define TCK_GPIO_Port GPIOA
#define SWO_Pin GPIO_PIN_3
#define SWO_GPIO_Port GPIOB
#define SOS_BTN_Pin GPIO_PIN_5
#define SOS_BTN_GPIO_Port GPIOB
