dev-gabin/Retrace-Project/stm32/drawer/Core/Src/main.c

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
/* Includes ------------------------------------------------------------------*/
#include "main.h"

/* USER CODE BEGIN Includes */
#include "serial_cmd.h"
#include "cmd_parser.h"
#include "drawer.h"
#include "emergency_button.h"
/* USER CODE END Includes */

I2C_HandleTypeDef hi2c2;

UART_HandleTypeDef huart1;
UART_HandleTypeDef huart2;

void SystemClock_Config(void);
static void MX_GPIO_Init(void);
static void MX_USART2_UART_Init(void);
static void MX_USART1_UART_Init(void);
static void MX_I2C2_Init(void);
/* USER CODE BEGIN 0 */
static UART_HandleTypeDef *drawer_reply_uart;

static void process_port(UART_HandleTypeDef *uart)
{
  char line[SERIAL_LINE_MAX], reply[SERIAL_LINE_MAX];
  SerialLineStatus status = serial_cmd_read_line(uart, line);
  if (status == SERIAL_LINE_TOO_LONG) {
    serial_cmd_send(uart, "ERR@UNKNOWN");
  } else if (status == SERIAL_LINE_OK) {
    Command cmd = {0};
    ParseResult result = cmd_parse(line, &cmd);
    if (result == PARSE_OK) {
      switch (cmd.type) {
        case CMD_DRAWER:
          if (drawer_reply_uart != NULL) {
            serial_cmd_send(uart, "ERR@DRAWER:BUSY");
          } else if (!drawer_i2c_check()) {
            serial_cmd_send(uart, "ERR@DRAWER:I2C");
          } else if (!drawer_open(cmd.drawer)) {
            serial_cmd_send(uart, "ERR@DRAWER:BUSY");
          } else {
            drawer_reply_uart = uart;
          }
          return;
        case CMD_LED: drawer_led(cmd.drawer, cmd.led_on); break;
        case CMD_LED_ALL_OFF: drawer_led_all_off(); break;
        case CMD_I2C_CHECK:
          serial_cmd_send(uart, drawer_i2c_check() ?
                          "OK@I2C:PCA9685" : "ERR@I2C:PCA9685");
          return;
        case CMD_PING: break;
      }
    }
    cmd_make_reply(result, &cmd, reply, sizeof(reply));
    serial_cmd_send(uart, reply);
  }
}
/* USER CODE END 0 */

/**
  * @brief  The application entry point.
  * @retval int
  */
int main(void)
{

  /* MCU Configuration--------------------------------------------------------*/

  /* Reset of all peripherals, Initializes the Flash interface and the Systick. */
  HAL_Init();

  /* Configure the system clock */
  SystemClock_Config();

  /* Initialize all configured peripherals */
  MX_GPIO_Init();
  MX_USART2_UART_Init();
  MX_USART1_UART_Init();
  MX_I2C2_Init();
  /* USER CODE BEGIN 2 */
  drawer_init(&hi2c2);
  emergency_button_init();
  serial_cmd_init(&huart1);
  serial_cmd_init(&huart2);
  /* USER CODE END 2 */

  /* Infinite loop */
  /* USER CODE BEGIN WHILE */
  while (1)
  {
    /* USER CODE END WHILE */

    /* USER CODE BEGIN 3 */
    DrawerEvent drawer_event = drawer_poll();
    if (drawer_event != DRAWER_EVENT_NONE && drawer_reply_uart != NULL) {
      serial_cmd_send(drawer_reply_uart,
                      drawer_event == DRAWER_EVENT_COMPLETE ?
                      "OK@DRAWER" : "ERR@DRAWER:I2C");
      drawer_reply_uart = NULL;
    }
    process_port(&huart1);
    process_port(&huart2);
    if (emergency_button_poll()) {
      serial_cmd_send(&huart1, "EVT@DRAWER:SOS");
      serial_cmd_send(&huart2, "EVT@DRAWER:SOS");
    }
  }
  /* USER CODE END 3 */
}

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
