dev-gabin/Retrace-Project/esp32/entrance_node/include/network_config.example.h

#ifndef ENTRANCE_NETWORK_CONFIG_H
#define ENTRANCE_NETWORK_CONFIG_H

// 이 파일을 network_config.h로 복사하고 실제 네트워크 값을 입력한다.
// network_config.h는 Git에서 제외된다.
static constexpr char WIFI_SSID[] = "";
static constexpr char WIFI_PASSWORD[] = "";
static constexpr char SERVER_HOST[] = "";  // Jetson의 LAN IP
static constexpr unsigned SERVER_PORT = 5000;
static constexpr char CLIENT_ID[] = "ENTRANCE";
static constexpr char CLIENT_PASSWORD[] = "";

#endif
