dev-gabin/Retrace-Project/(commit log)

2026-10-01 Configure STM32 pinmap for servo, laser, and PIR
    - TIM3 CH1/CH2 PWM 50Hz: PA6 SERVO_PAN, PA7 SERVO_TILT (PSC 83, ARR 19999, Pulse 1500)
    - PA8 LASER_EN: GPIO output, default low
    - PA10 PIR_IN: EXTI10 rising/falling, pull-down, EXTI15_10 NVIC enabled
    - Keep USART2 115200 (VCP), FW_F4 V1.28.3
2026-10-01 Add STM32Cube VS Code project settings
2026-10-01 Add STM32 pinmap document
2026-10-02 Update project structure for hub-node architecture
    - Rename arduino/src/buttuon to button
    - Add esp32 nodes: entrance_node, buzzer_tag
    - Add Jetson communication modules: MqttLink, BleBuzzer, PhoneNotifier
2026-10-02 Replace Arduino with STM32 drawer node and group STM32 projects
    - Remove arduino/ (drawer node moves to STM32 #2)
    - Move stm32/ to stm32/laser_head/
    - Rename ArduinoLink to DrawerLink
    - Update README and STM32 pinmap doc paths
    [Retrace_STM32.ioc, main.c, main.h]
2026-10-02 Update docs: merge pinmap for all boards, add protocol v0.3
2026-10-02 docs: 서랍 배치를 2열 3행으로 수정
2026-10-02 서랍 문자열 취소선 인식 부분 수정
2026-10-02 서랍 취소선 부분 재수정
2026-10-03 Add serial command frame to laser head
2026-10-03 Add pan/tilt servo control for AIM command
2026-10-03 Add laser on/off and HOME commands
2026-10-03 Add drawer firmware and STM32 host tests
2026-10-03 Add BLE buzzer tag firmware
    [buzzer_control.h, main.cpp]
2026-10-03 Record verified STM32 build and host test results
2026-10-03 Rename STM32 laser head project to main unit
2026-10-04 Remove ESP32 host tests and move network build-check config
2026-10-04 Remove STM32 host tests and update shared docs
2026-10-04 Track tool config files and pin their line endings
2026-10-04 Add Linux IntelliSense config for Jetson
2026-10-04 Fix STM32 IntelliSense configuration
2026-10-04 Fix ESP32 IntelliSense configuration
2026-10-04 Clean up Jetson IntelliSense configuration
2026-10-04 Remove web framework execution handover reference
    Removed web framework execution handover section from README.
2026-10-04 README.md 수정
2026-10-04 REDNE.md 수정
2026-10-04 안경->지갑
2026-10-04 REDME.md 정리
2026-10-05 best.pt 추가
2026-10-06 enviroment.md jetson 수정
2026-10-06 best_vl.pt 마우스 오탐학습 모델 업로드
2026-10-06 stm32 기존 옛날 레이저 폴더 삭제
2026-10-06 서랍 서보 순서변경
2026-10-06 gitkeep 삭제
2026-10-07 interface_policy.md 추가
2026-10-07 추론 confidence hysteresis 정책 추가
2026-10-07 모델pt 추가 및 테스트 py변경
2026-10-07 ESP32 브랜치 bundle 설정 유지
2026-10-07 추론 활성화 및 confidence 정책 문서 추가
2026-10-07 mouse 보강 모델 테스트
2026-10-07 최종 모델 업로드
2026-10-07 feat(jetson): V6 YOLO 모델과 Python 추론 구조 적용
2026-10-07 ESP32 입구 노드 업로드 환경 및 조명 시간 조정
2026-10-07 서랍 노드를 PCA9685 I2C 제어로 전환
2026-10-07 protocal.md 서랍 번호 수정
2026-10-08 client_bluetooth와 SET 명령어 추가
2026-10-08 server seperator 변경
2026-10-08 bluetooth 연결방식 변경
2026-10-08 PCA9685 I2C 오류 상태 복구
2026-10-08 USART2 인터럽트 설정을 CubeMX와 동기화
2026-10-08 서랍 노드 PCA9685 및 Bluetooth 제어 통합
2026-10-08 SOS 이벤트에 DRAWER ID 추가
2026-10-08 client_bluetooth 일반화
2026-10-08 서랍 비상 버튼 설명 수정 및 Jetson 서버 로그 이벤트 추가
2026-10-08 클라이언트 ID 기반 명령어로 변경 및 README 문서 업데이트
2026-10-08 PING 명령어 처리 로직 추가 및 오류 응답 형식 수정
2026-10-08 ERR메세지 통일
2026-10-08 Bluetooth DB 오류 응답 형식 수정
2026-10-08 Jetson 물체 기록 및 레이저 연동 추가
2026-10-08 STM32 메시지 구분자를 골뱅이 형식으로 통일
2026-10-08 Jetson STM32 메시지 골뱅이 형식 반영
2026-10-08 develop 잘못된 병합 결과 복구
2026-10-08 메인 유닛 서보 PWM 범위 확장
2026-10-08 Jetson STM32 이벤트 접두사 판별 수정
    [stm32_link.py]
2026-10-09 현관등 LED 4개 출력 지원
2026-10-09 현관등 LED 핀맵 문서 정리
2026-10-09 Esp 부저 추가
2026-10-09 Client 정리 및 BLE 기능 추가
2026-10-09 SERVER @ 정리
2026-10-09 Drawer @ 정리
2026-10-09 카메라 설정 및 자동 노출 안정화 추가, 명령 응답 형식 수정
    [cmd_parser.c, cmd_parser.h]
2026-10-09 명령 응답 형식 수정: 오류 메시지를 "ERR@UNKNOWN"으로 변경
    [main.c]
2026-10-09 네트워크 구성 파일 추가: 빌드 체크 및 예시 설정 포함
2026-10-09 .gitkeep 제거
2026-10-10 웹 제외 통합 테스트 완료
2026-10-10 Jetson HTTP API와 장치 제어 연동
2026-10-10 웹을 Jetson 실시간 API에 연동
2026-10-10 Jetson 통합 실행 설정 정리
2026-10-11 laser 원상복구 추가
2026-10-11 현관등 클라이언트로 교체
2026-10-11 drawer & button phone 알림 연결 설정
2026-10-11 web 물건등록 83개 클래스
2026-10-11 촬영용 카메라 실시간 페이지
2026-10-11 레이저 각도 자동보정 추가
2026-10-11 테스트용 카메라 제거
2026-10-11 pir 사람 감지 조절
2026-10-11 좌표보정
2026-10-11 레이저보정 2
2026-10-11 현관 알림 및 레이저 보정 개선
2026-10-11 Improve laser calibration and lower movement threshold
2026-10-11 전체적 방향성 수정
2026-10-12 Restore manual laser guidance while preserving photo lookup
2026-10-12 Apply PIR-only detection and calibrated laser aiming
2026-10-12 웹 서랍 번호 배치 수정
2026-10-12 YOLO 검출 신뢰도 기준 조정
2026-10-12 LCD 새 기록 후 날씨 표시
2026-10-12 Jetson 서버 연결 타임아웃 및 HTTP 보안 헤더 추가
2026-10-12 미사용 Wi-Fi 클라이언트와 YOLO 모델 정리
2026-10-12 ESP32 TCP 통합 기준으로 프로젝트 문서 갱신
2026-10-12 알림 우선순위 테스트를 현재 정책에 맞게 수정
2026-10-12 ESP32 현관 노드 네트워크 설정 예제 복구
2026-10-13 Update Markdown docs for current Retrace implementation
2026-10-13 Sync current project documentation with main
2026-10-13 REAME.md 시스템 구조도 수정
2026-10-13 REAME.md 시스템 구조도 수정2
2026-10-14 REDME.md 수정
2026-10-14 REDME.md 마지막 수정
